Joe9238/AutoGrow/WiFi LoRa 32(v3)/Soil Sensor Reader Configuration.jpg

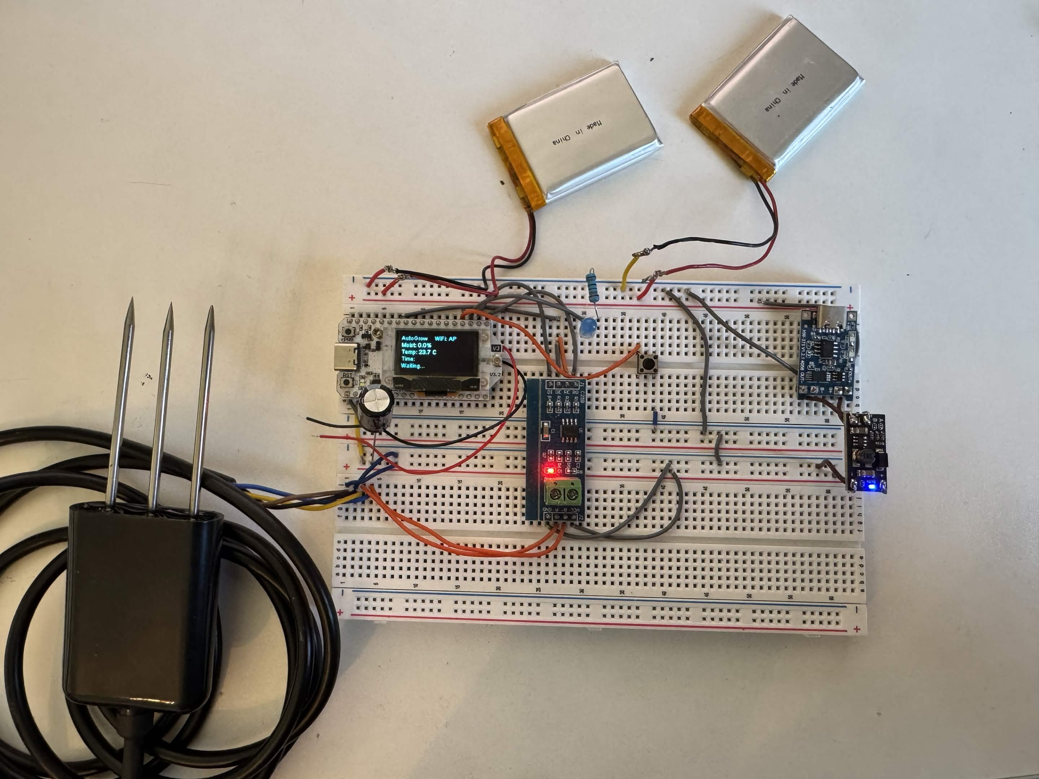
WiFi LoRa 32(v3)/Soil Sensor Reader Configuration.jpg
