Joe9238/AutoGrow/ESP32-S3-Zero/Valve Controller Configuration View 1.jpg

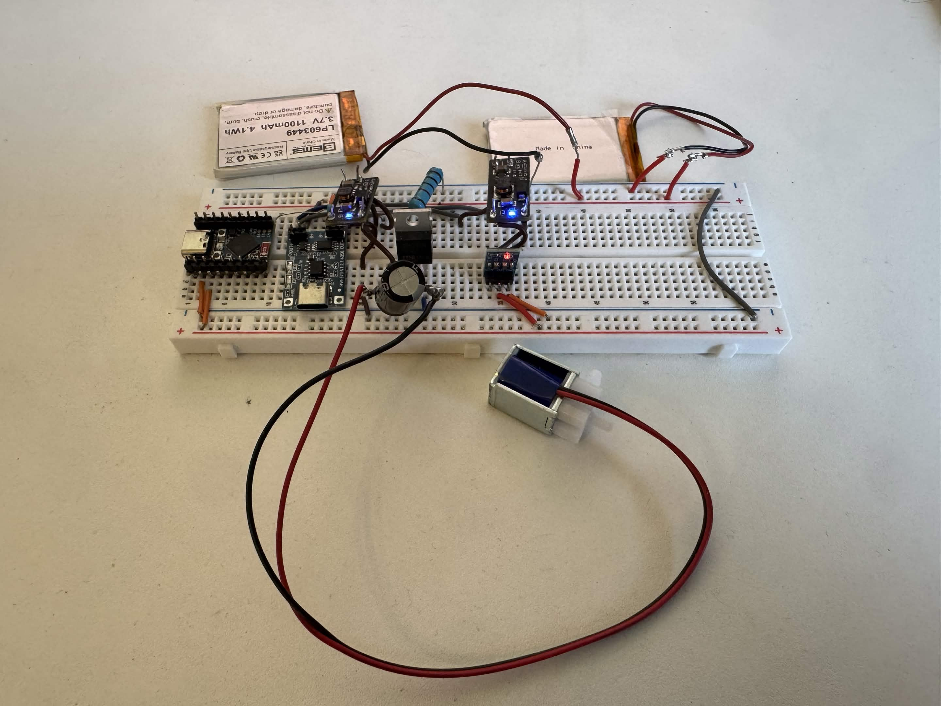
ESP32-S3-Zero/Valve Controller Configuration View 1.jpg
