Joe9238/AutoGrow/ESP32-S3-Zero/Valve Controller Wiring Diagram.png

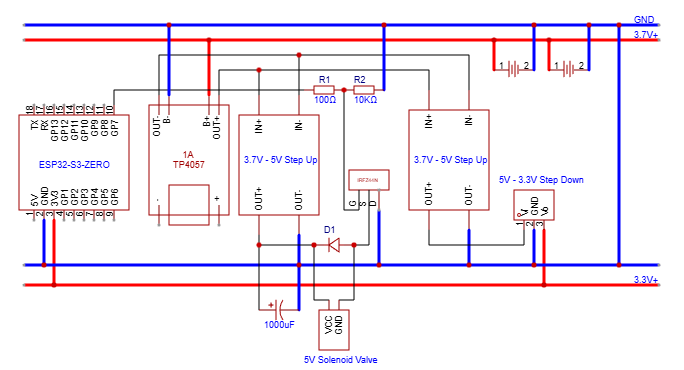
ESP32-S3-Zero/Valve Controller Wiring Diagram.png
