Joe9238/AutoGrow/WiFi LoRa 32(v3)/Hub Wiring Diagram.png

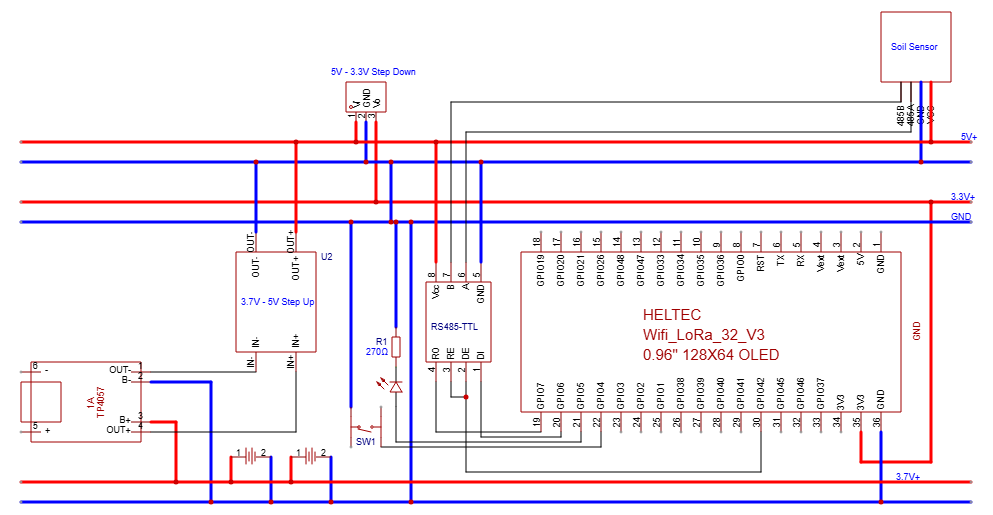
WiFi LoRa 32(v3)/Hub Wiring Diagram.png
