Joe9238/AutoGrow/ESP32-S3-Zero/Valve_Controller/Valve_Controller.ino

#include <WiFi.h>
#include <esp_now.h>

// -------------------- MOSFET Pin --------------------
const int VALVE_PIN = 7;

// -------------------- Peer MAC --------------------
uint8_t heltecMac[] = { 0x10, 0x51, 0xDB, 0x2B, 0x5A, 0x6C };

// -------------------- Timing --------------------
unsigned long stateStartTime = 0;
bool valveOn = false;

unsigned long lastWaterCommand = 0;
const unsigned long WATER_TIMEOUT = 15000; // 15 seconds safety cutoff

// -------------------- ESP-NOW Receive --------------------
void onReceive(const esp_now_recv_info *info, const uint8_t *incomingData, int len) {
  char msg[64];
  memcpy(msg, incomingData, len);
  msg[len] = '\0';

  if (strcmp(msg, "WATER_ON") == 0) {
    lastWaterCommand = millis(); // refresh timer
    digitalWrite(VALVE_PIN, HIGH);
    valveOn = true;
    Serial.println("Valve OPEN (keep-alive)");
  }

  if (strcmp(msg, "WATER_OFF") == 0) {
    digitalWrite(VALVE_PIN, LOW);
    valveOn = false;
    Serial.println("Valve CLOSED");
  }

  if (strcmp(msg, "TIME?") == 0) {
    char reply[32];
    sprintf(reply, "TIME:%lu", millis() / 1000);
    esp_now_send(info->src_addr, (uint8_t *)reply, strlen(reply));
  }
}

// -------------------- Setup --------------------
void setup() {
  Serial.begin(115200);
  delay(1000);

  pinMode(VALVE_PIN, OUTPUT);
  digitalWrite(VALVE_PIN, LOW); // Start CLOSED
  valveOn = false;

  WiFi.mode(WIFI_STA);
  esp_now_init();
  esp_now_register_recv_cb(onReceive);

  esp_now_peer_info_t peerInfo = {};
  memcpy(peerInfo.peer_addr, heltecMac, 6);
  esp_now_add_peer(&peerInfo);

  stateStartTime = millis();
  Serial.println("Valve controller started");
}

// -------------------- Loop --------------------
void loop() {
  unsigned long now = millis();

  if (valveOn) {
    if (now - lastWaterCommand > WATER_TIMEOUT) {
      digitalWrite(VALVE_PIN, LOW);
      valveOn = false;
      Serial.println("Valve CLOSED (timeout safety)");
    }
  }
}
