Joe9238/AutoGrow/(commit log)

2026-01-19 Basic code to read and output soil sensor moisture readings
2026-01-19 Renamed file so that the Arduino IDE accepts it
2026-01-19 Added temperature readings and cleared up initial code
2026-02-09 Created basic loop to intermittently open the valve
2026-02-10 Added circuit diagrams for hub and valve controller
2026-04-14 Finalised device registration and added basic MQTT listening
2026-04-14 Added device registration process to hub
2026-04-15 Sensor readings are saved and displayed. Location data input added for hubs.
2026-04-15 Hub can now connect to HiveMQ and send sensor data
2026-04-15 Added moisture thresholds and a scheduled job that sends weather data and thresholds per device to HiveMQ
2026-04-15 Hub and valve controller release water based on sensor and MQTT data
2026-04-17 Added notifications and the ability to delete/rename devices
2026-04-17 Updated hub wiring diagram to include button, LED, and resistor
2026-04-20 Added sensor readings chart that accidentally got missed in a previous commit
2026-04-24 Updated device images to show current configuration
